FangnanWei/ActiveAmplifier/Document/MO600PAL-V11 硬件测试代码/MO600PAL-V11 硬件测试代码.docx

MO600PAL-V11 硬件测试代码

1、OLED 128 x 64 测试

全亮3秒 全黑3秒 全屏字符 3秒 循环

2、EC11旋转编码器测试

顺时针旋转依次点亮EDPWR EDSYS EDERR三个LED

逆时针旋转依次点亮EDERR EDSYS EDPWR三个LED

3、PWM测试

LVELPWM出50%占空比波形

4、按键蜂鸣器测试

每次按下SYSRST按键，按键按下有效，BEEP输出4kHz方波500毫秒
