FangnanWei/ActiveAmplifier/Reference/老项目代码/Dpa600V2PanelCtrler/stm8.png

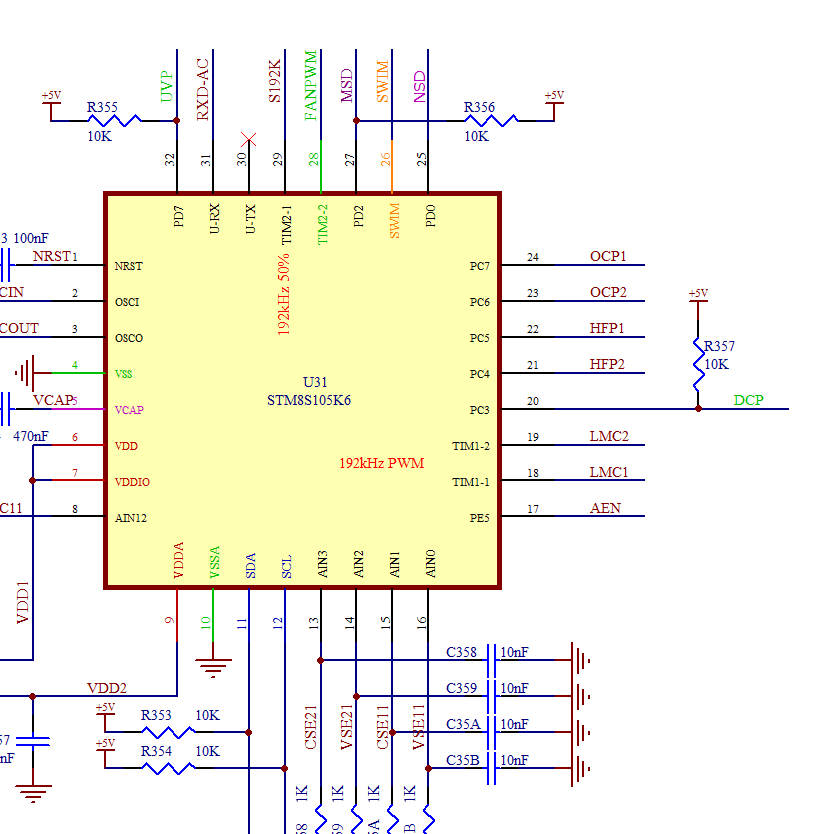
Reference/老项目代码/Dpa600V2PanelCtrler/stm8.png
