FangnanWei/ActiveAmplifier/Document/MO600PAL-V11 硬件测试代码/MO600DSP-V10-P3-5.Sch-200105.pdf

LINKLED | 25 DUPLED | 26 ACTLED | 27 VDD | 28 GND | 29 XI/CLKIN | 30 XO | 31 SCSn | 32 SCLK | 33 MISO | 34 MOSI | 35 INTn | 36

U31

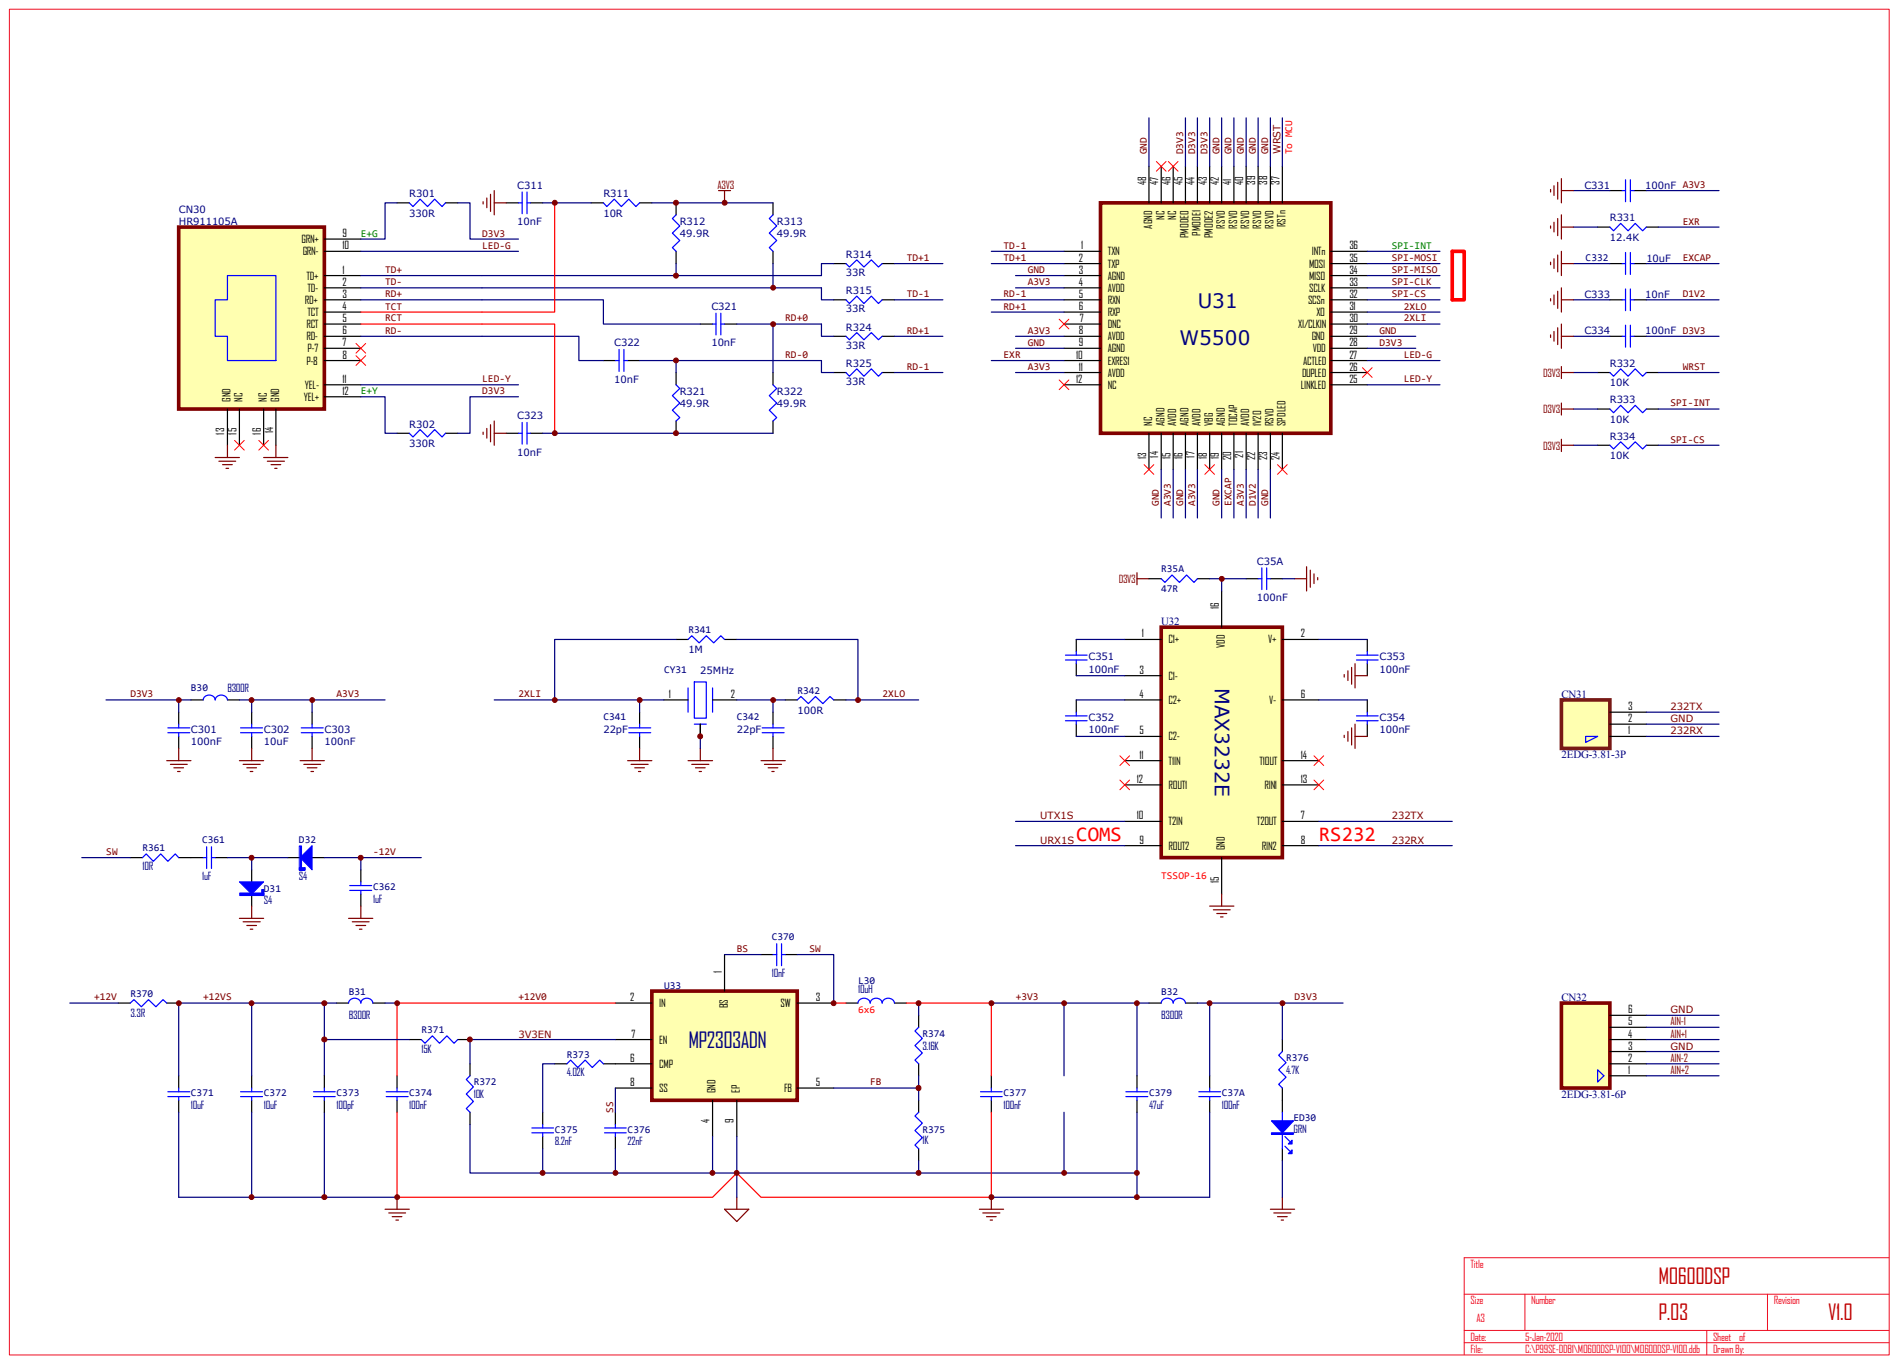
[picture p5: page 1]

RSTn 37 RSVD 38 RSVD 39 RSVD 40 RSVD 41 RSVD 42 PMODE2 43 PMODE1 44 PMODE0 45 NC 46 NC 47 AGND 48

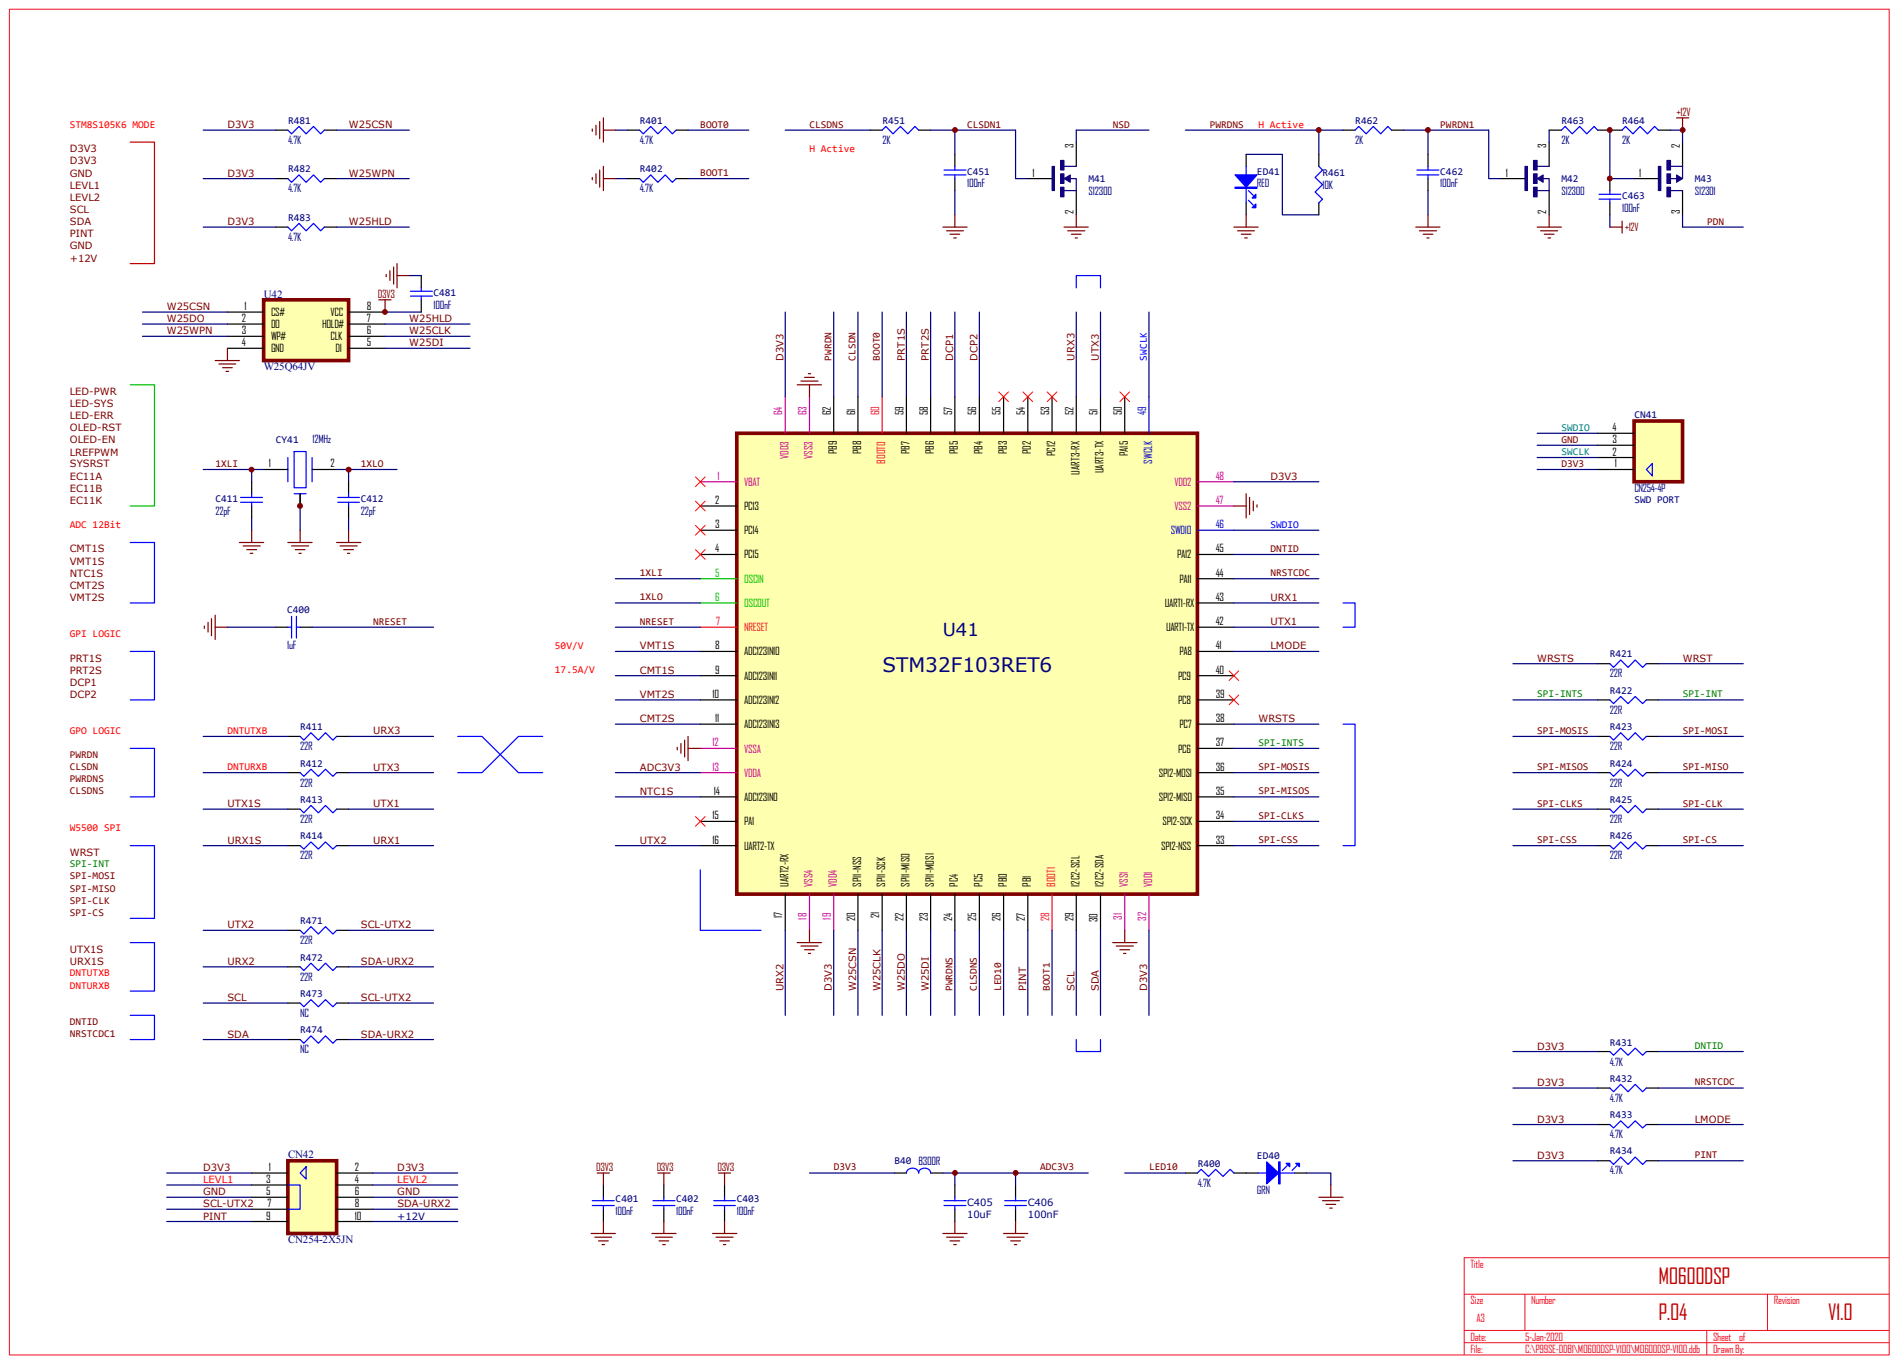
[picture p6: page 2]

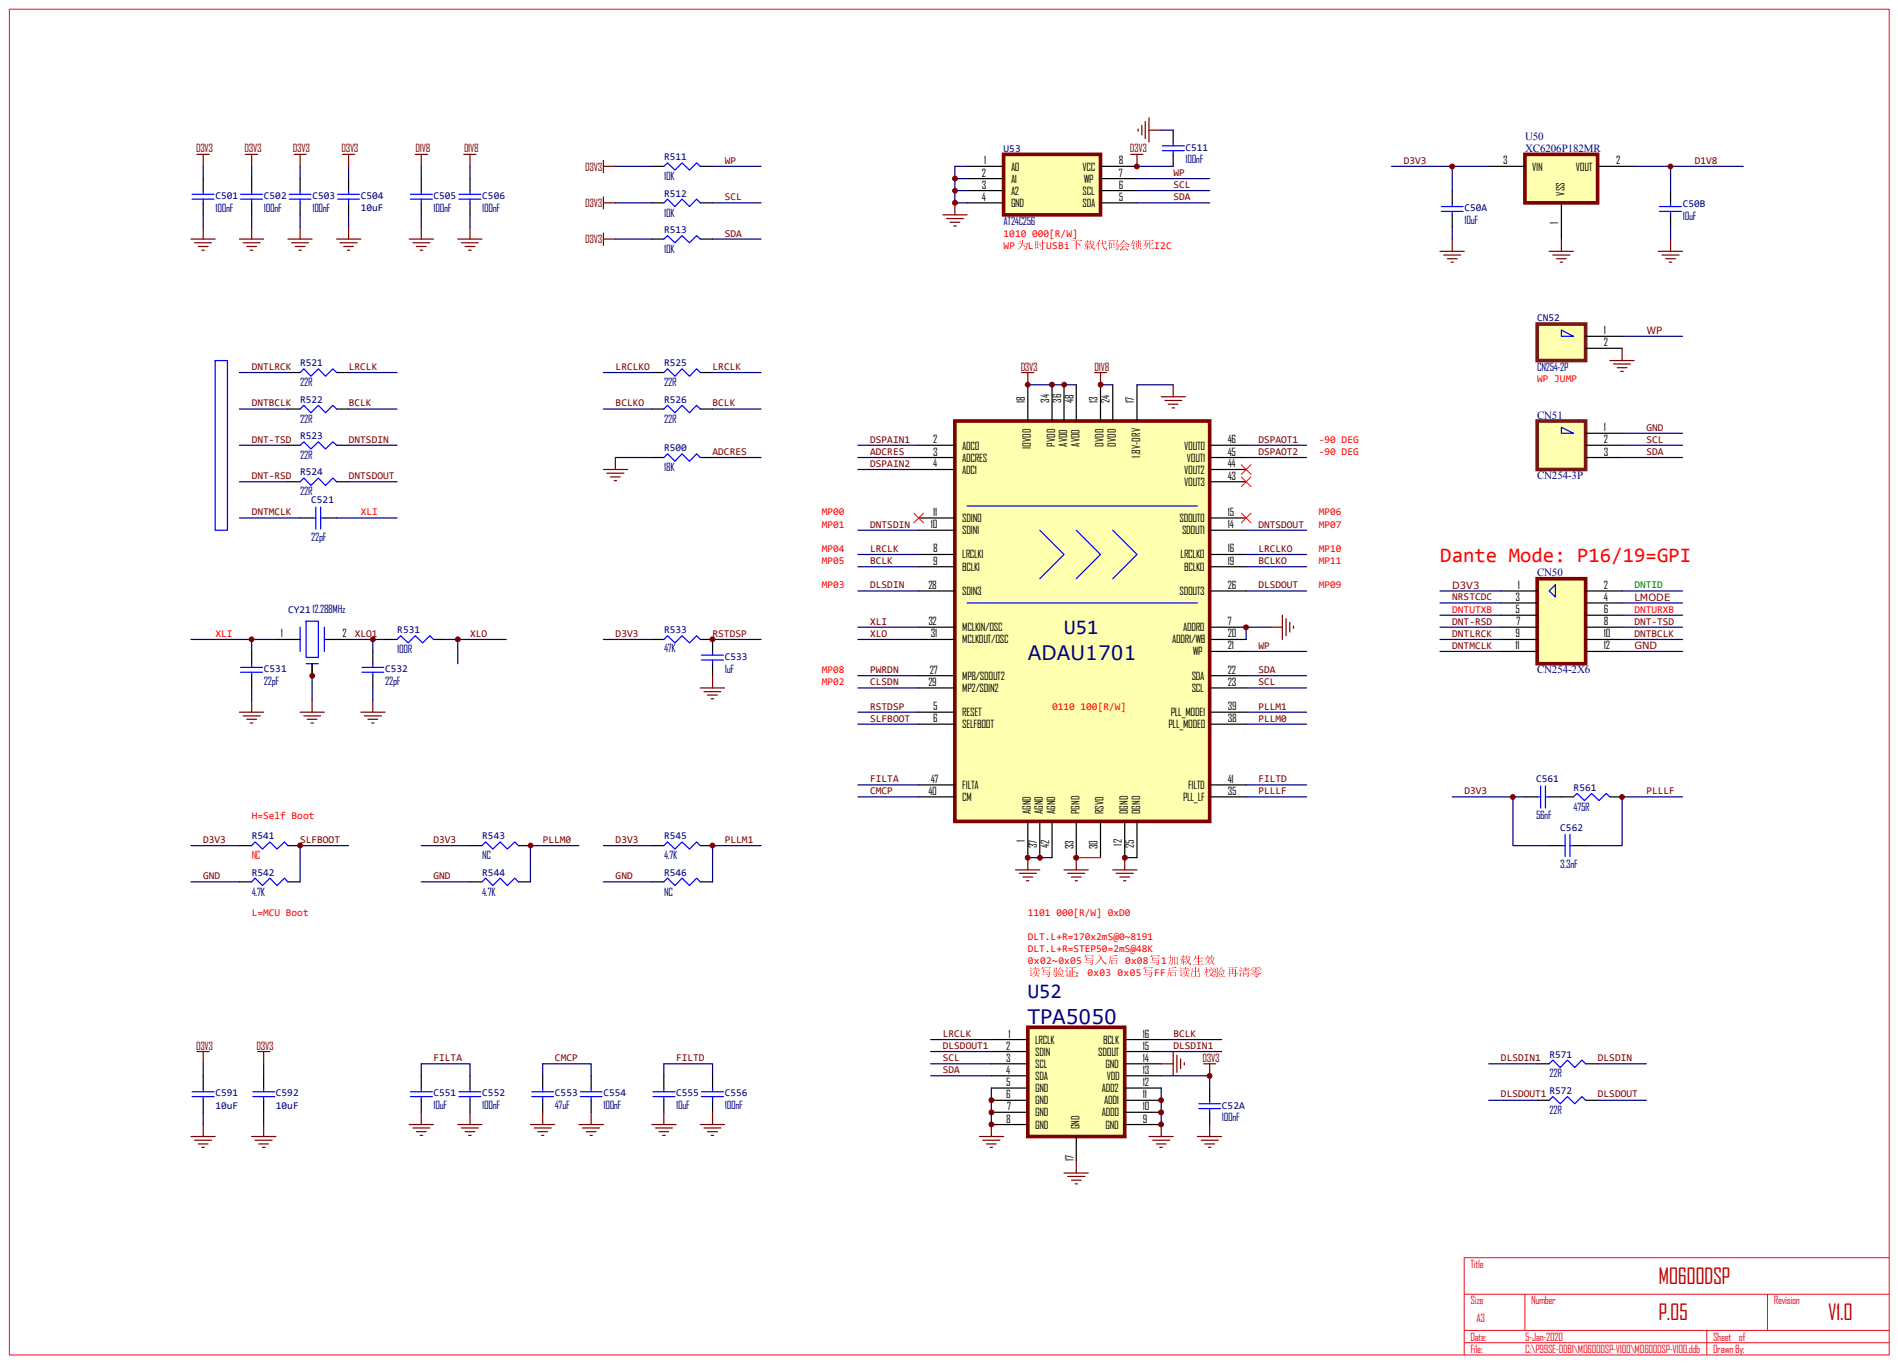
[picture p7: page 3]
