FangnanWei/ActiveAmplifier/Document/ApDoc/DSPDNT-V1.0-40-181101.pdf

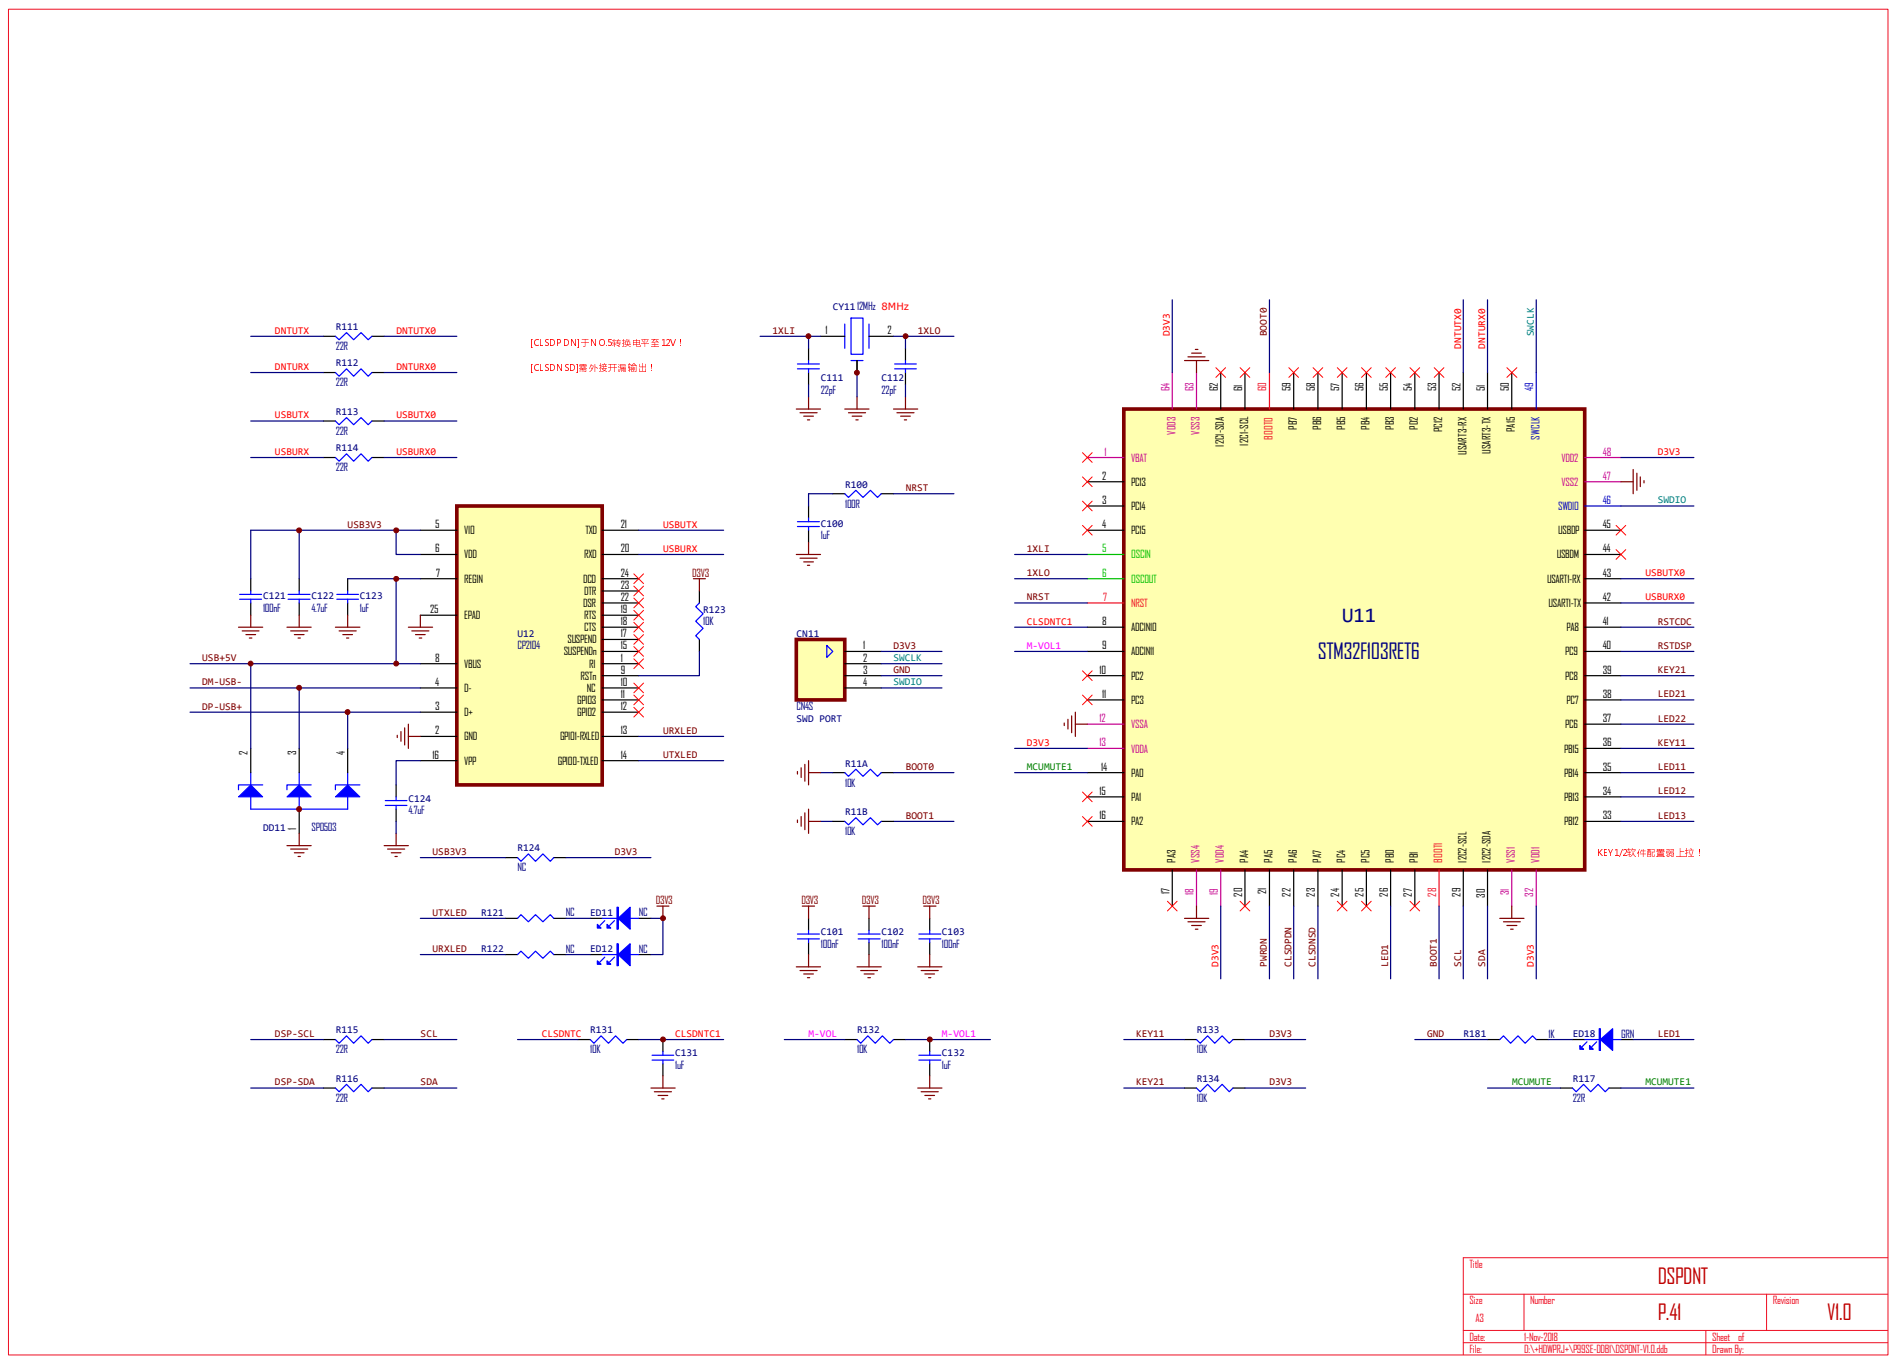
[picture p8: page 1]

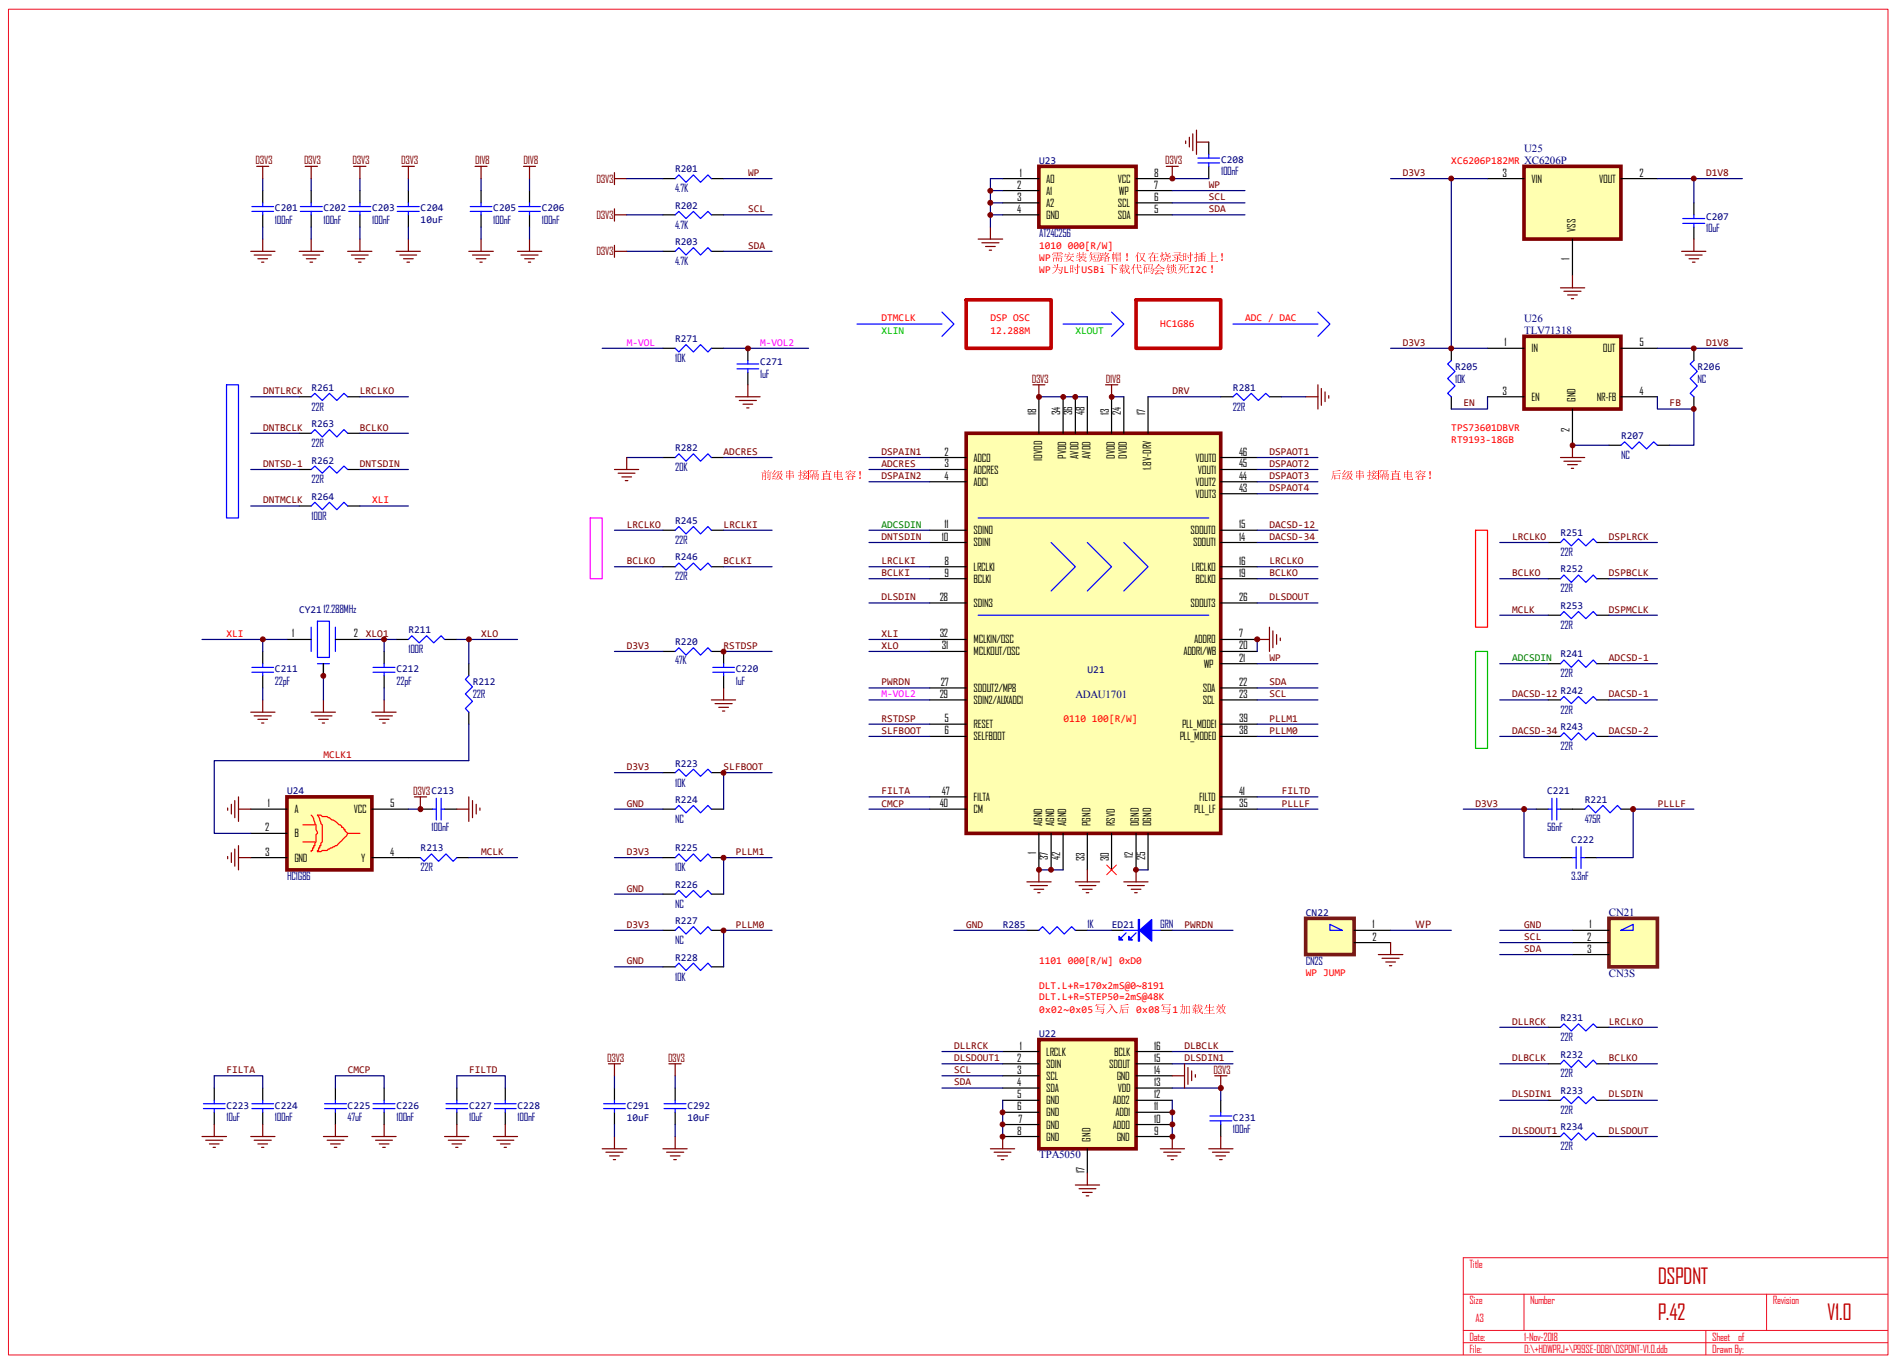
[picture p9: page 2]
