FangnanWei/ActiveAmplifier/Document/MO600PAL-V11 硬件测试代码/DPA600-00V21-FCTRL-1.SCH.pdf

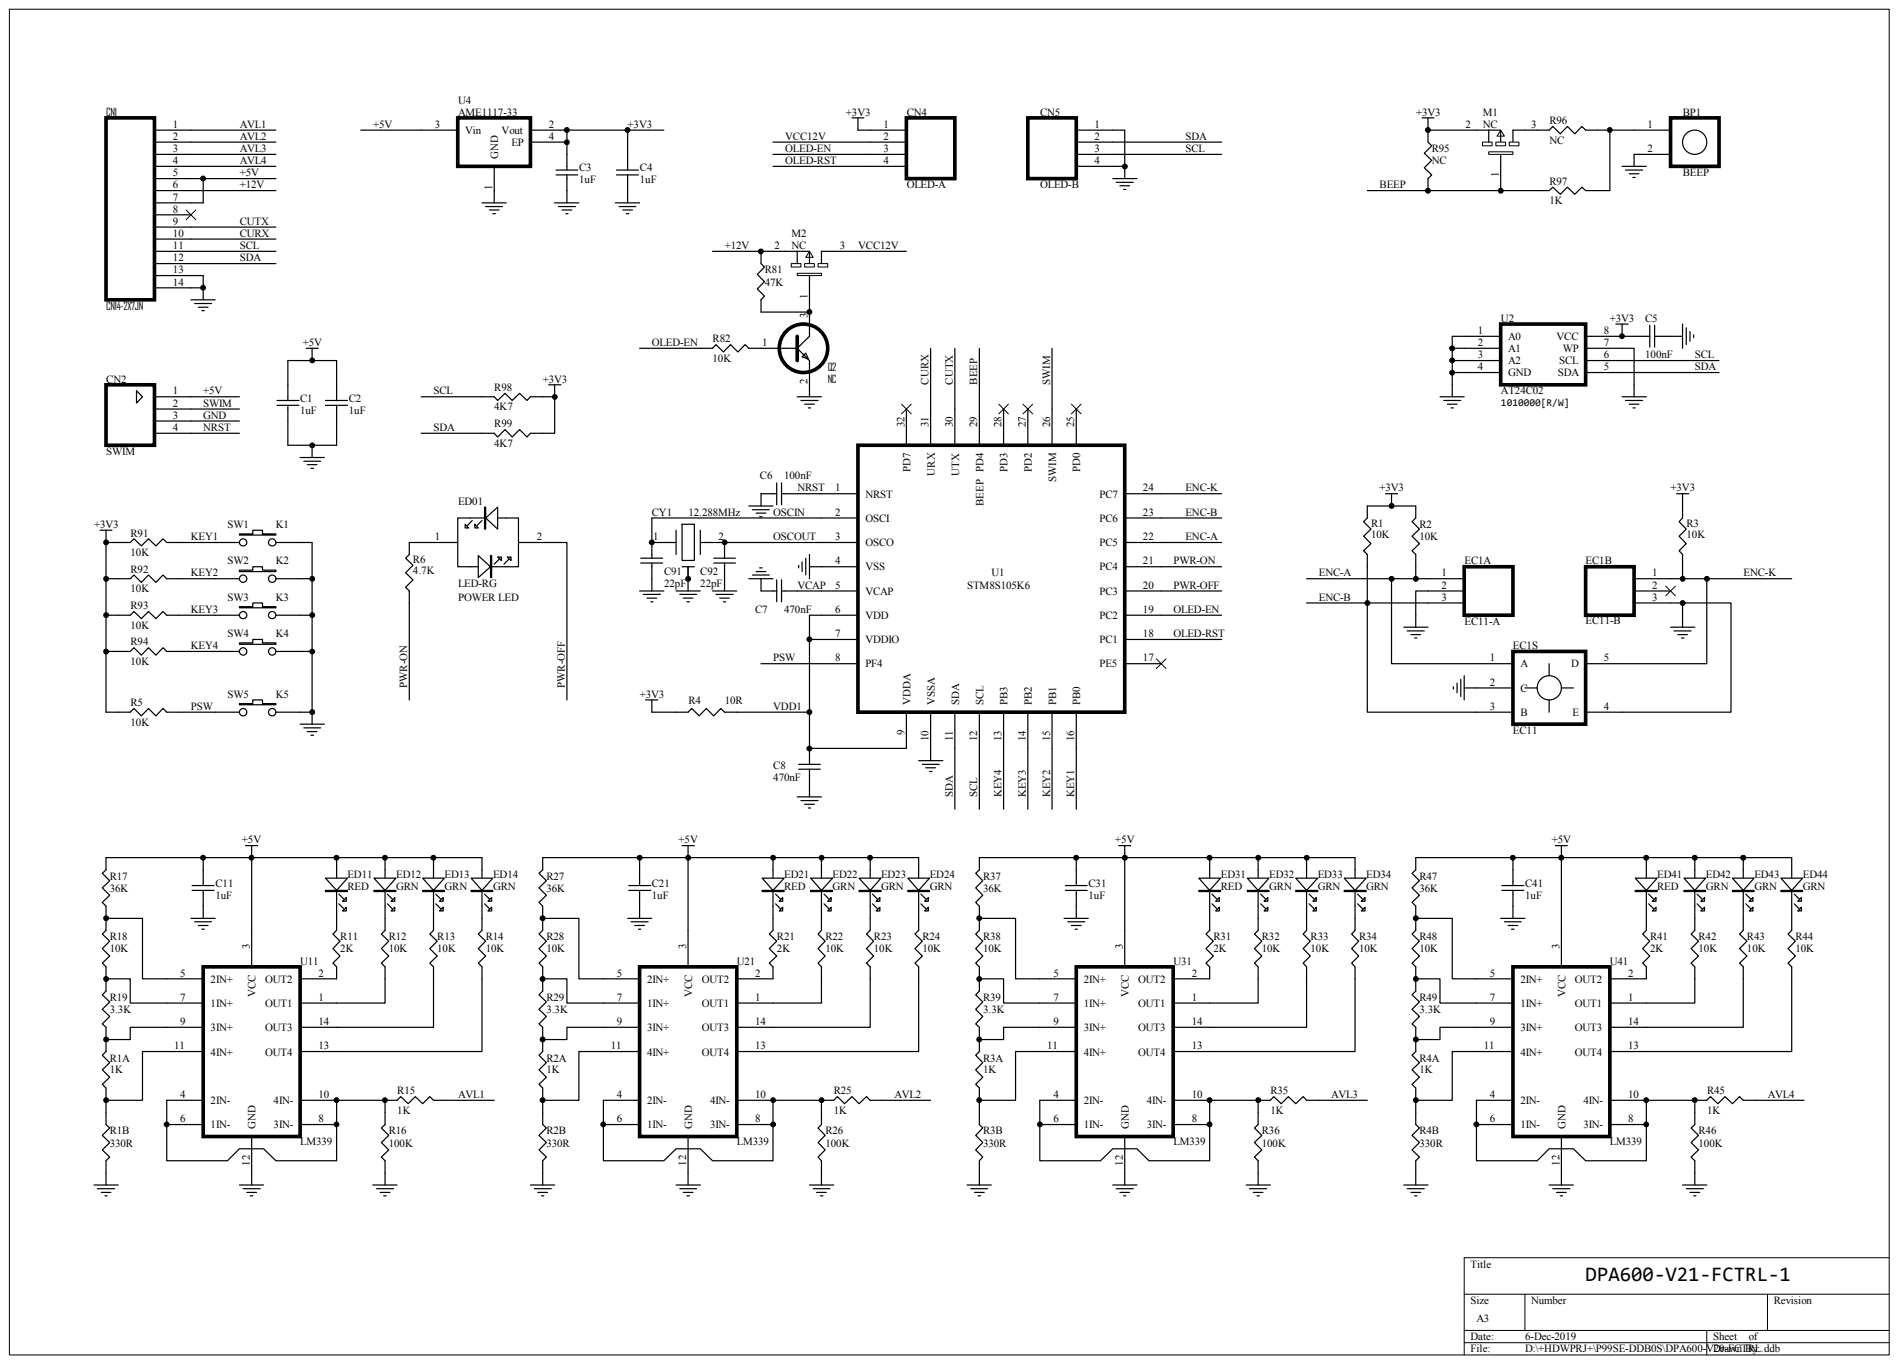
[picture p10: page 1]
