FangnanWei/ActiveAmplifier/Document/MO600PAL-V11 硬件测试代码/MO600PAL-V11-01.sch-001.pdf

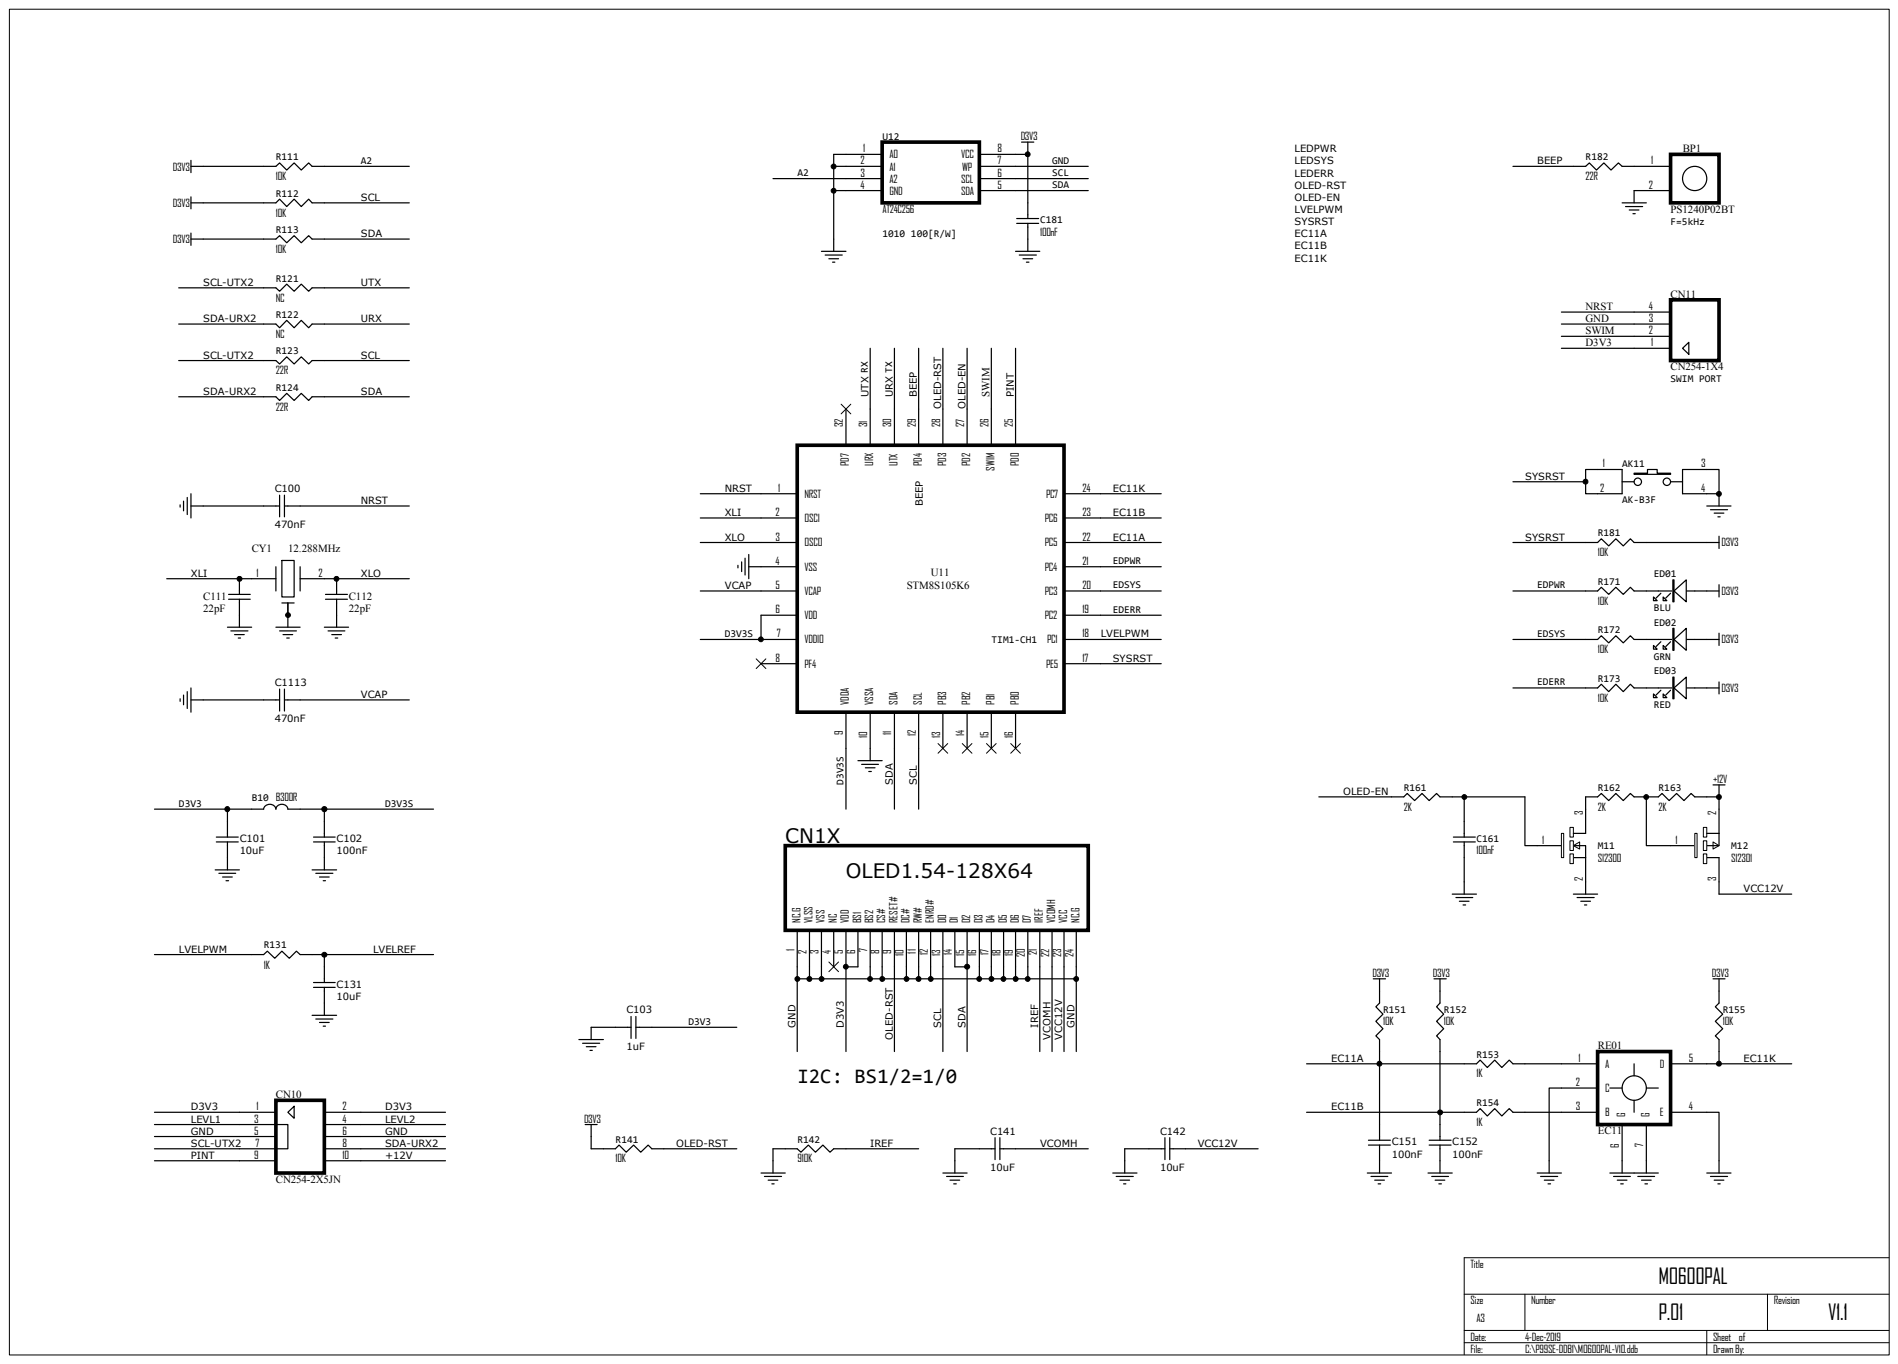
[picture p11: page 1]
