FangnanWei/ActiveAmplifier/Document/MO600PAL-V11 硬件测试代码/2020-01/MO-2300D DSP板MCU程序-1.pdf

## DSP板STM32上电过程

## 7、等待前控板接收并加载完参数表

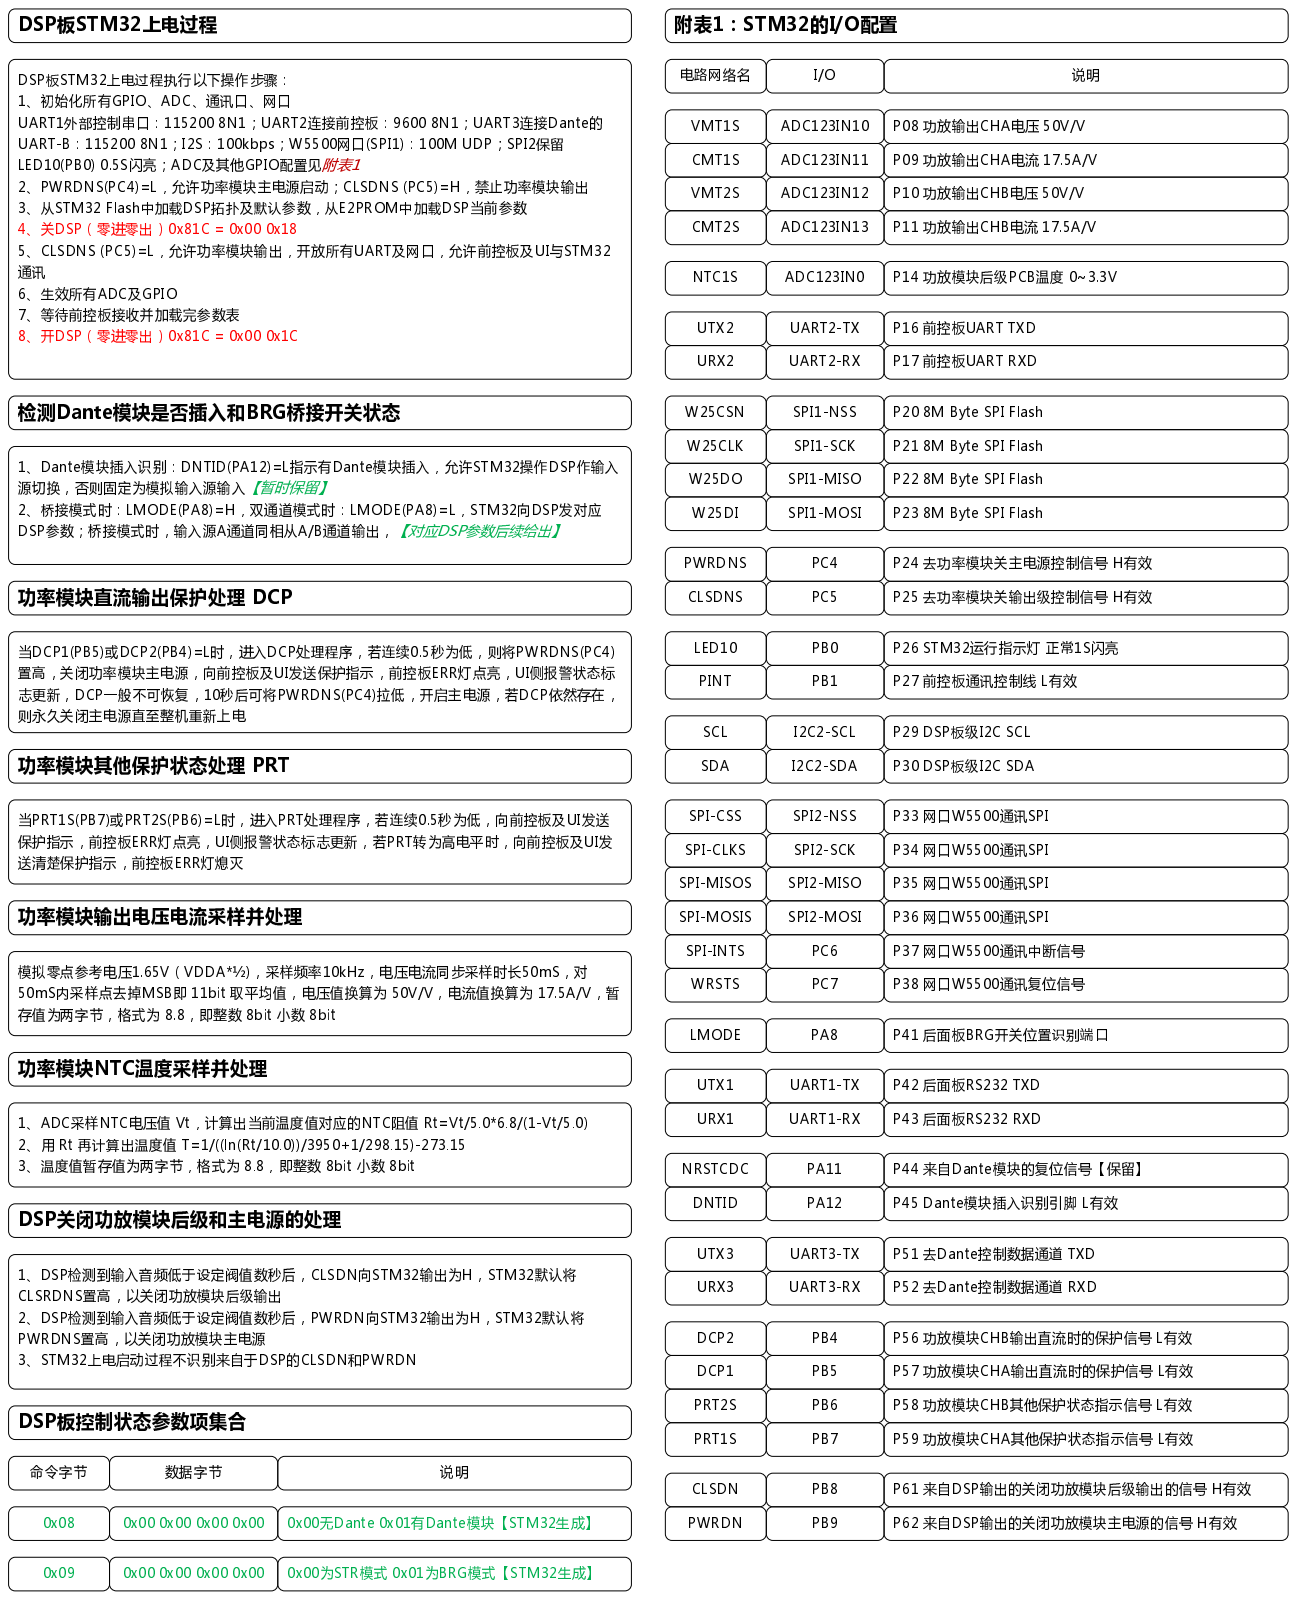
[picture p12: page 1]

1、初始化所有GPIO、ADC、通讯口、网口

2、PWRDNS(PC4)=L，允许功率模块主电源启动；CLSDNS (PC5)=H，禁止功率模块输出

2、桥接模式时：LMODE(PA8)=H，双通道模式时：LMODE(PA8)=L，STM32向DSP发对应
DSP参数；桥接模式时，输入源A通道同相从A/B通道输出，

当DCP1(PB5)或DCP2(PB4)=L时，进入DCP处理程序，若连续0.5秒为低，则将PWRDNS(PC4)
置高，关闭功率模块主电源，向前控板及UI发送保护指示，前控板ERR灯点亮，UI侧报警状态标

志更新，DCP一般不可恢复，10秒后可将PWRDNS(PC4)拉低，开启主电源，若DCP依然存在，
则永久关闭主电源直至整机重新上电

当PRT1S(PB7)或PRT2S(PB6)=L时，进入PRT处理程序，若连续0.5秒为低，向前控板及UI发送
保护指示，前控板ERR灯点亮，UI侧报警状态标志更新，若PRT转为高电平时，向前控板及UI发
送清楚保护指示，前控板ERR灯熄灭

50mS内采样点去掉MSB即 11bit 取平均值，电压值换算为 50V/V，电流值换算为 17.5A/V，暂
存值为两字节，格式为 8.8，即整数 8bit 小数 8bit

1、ADC采样NTC电压值 Vt，计算出当前温度值对应的NTC阻值 Rt=Vt/5.0*6.8/(1-Vt/5.0)

2、用 Rt 再计算出温度值 T=1/((ln(Rt/10.0))/3950+1/298.15)-273.15
3、温度值暂存值为两字节，格式为 8.8，即整数 8bit 小数 8bit

## 需控制的DSP项目说明

DSP模式名称 | 说明
输入源选择 | 0x000h = 0x00 0x00 0x00 0x00 / 0x00 0x00 0x00 0x01【前控板0x12=0x00 / 0x01 = 模拟输入/Dante输入】
CHA/CHB STR模式 | 0x111h = 0x00 0x00 0x00 0x00 / 0x112h = 0x00 0x00 0x00 0x00【后面板BRG开关=L为STR模式】
CHA输入BRG模式 | 0x111h = 0x00 0x00 0x00 0x00 / 0x112h = 0x00 0x00 0x00 0x01【后面板BRG开关=H为BRG模式】
CHA/CHB主衰减 | 0x10Fh/0x110h = 0x00 0x80 0x00 0x00~0x00 0x00 0x03 0x47【前控板0x51/0x52= 0x00~0xB0(0~-80dB)】
CHA/CHB静音 | 0x10Bh/0x10Dh = 0x00 0x80 0x00 0x00/0x00 0x00 0x00 0x00【前控板0x53/0x54= 0x00/0x01(通过/静音)】
CHA/CHB输入增益 | 0x007h/0x008h = 0x00 0xFF 0x64 0xC1/0x00 0x80 0x00 0x00/0x00 0x40 0x26 0xE7【前控板0x13=0x00/0x01/0x02】
4R-70V模式 | 0x105h = 0x00 0x59 0x99 0x9A / 0x106h = 0x00 0x59 0x99 0x9A【前控板0x11=0x00为4R-70V模式】
8R-100V模式 | 0x105h = 0x00 0x80 0x00 0x00 / 0x106h = 0x00 0x80 0x00 0x00【前控板0x11=0x01为8R-100V模式】
