FangnanWei/ActiveAmplifier/Document/MO600PAL-V11 硬件测试代码/2020-01/MO-2300D OLED 界面设计-2.pdf

## 前控板上电过程

## 前控板上电过程执行以下操作：

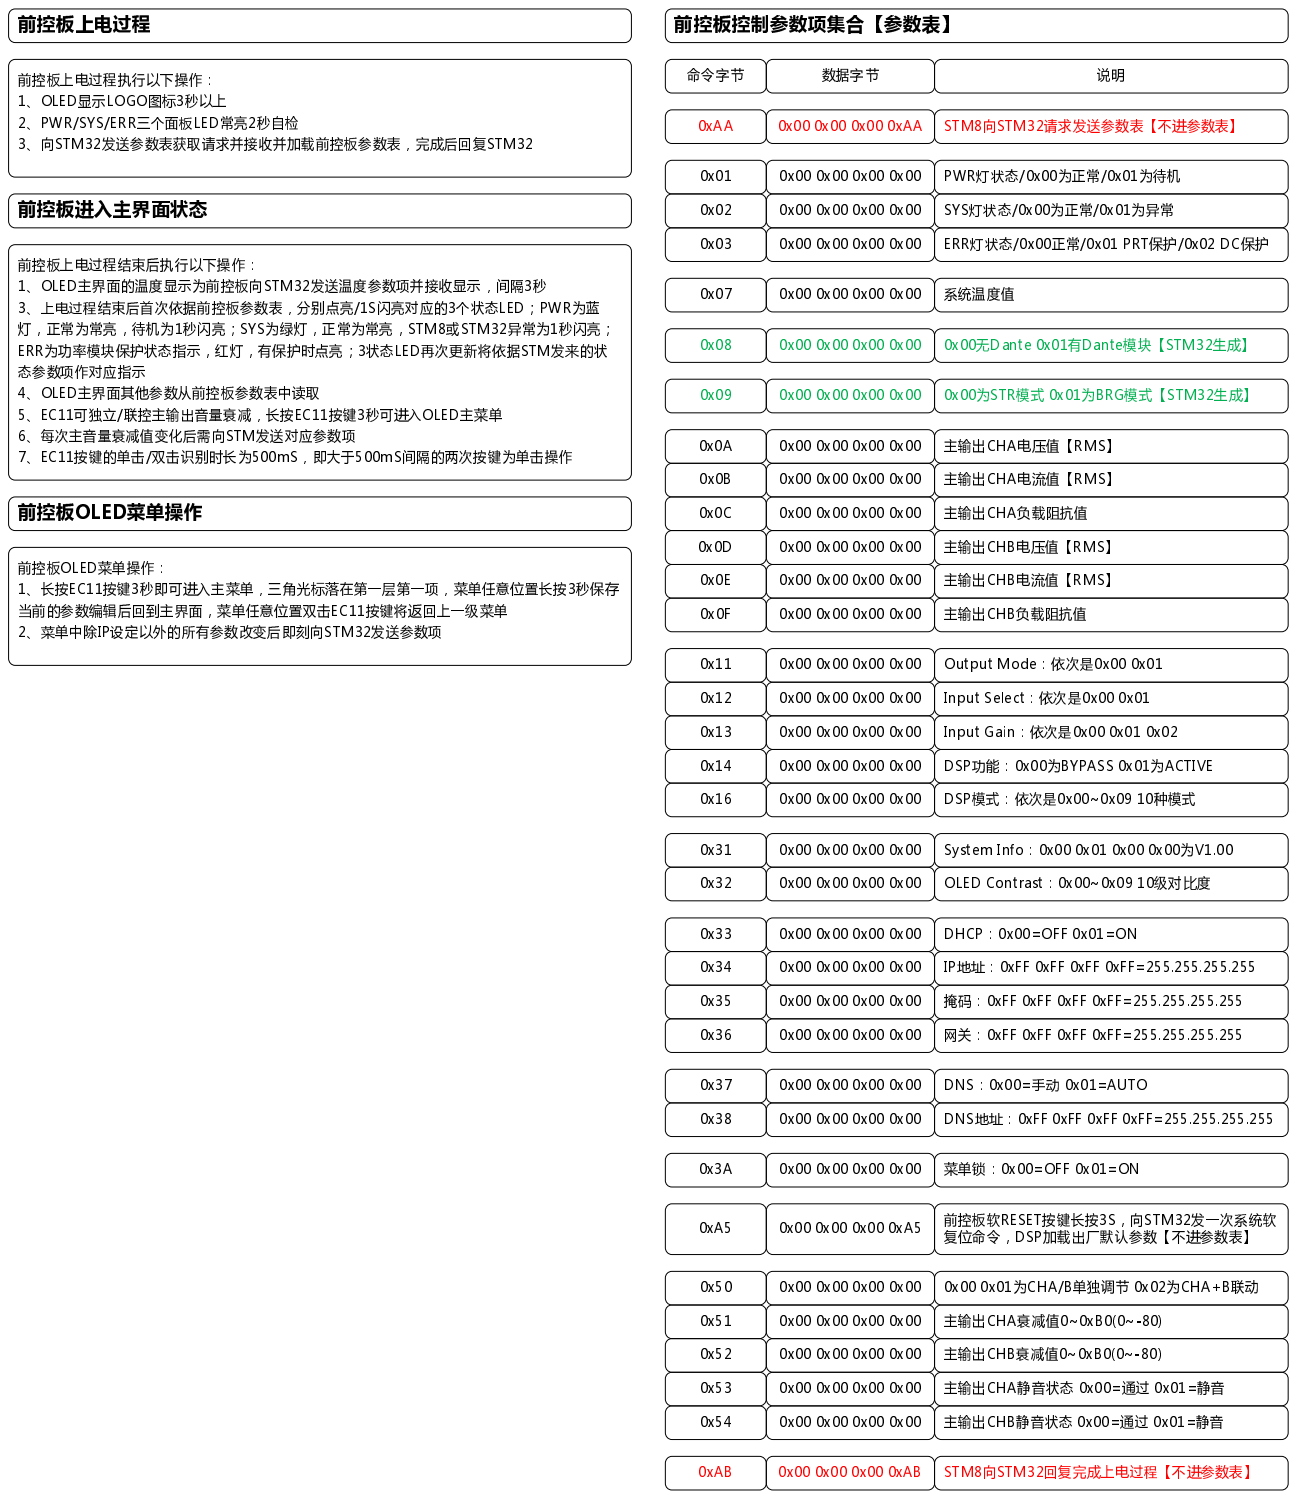
[picture p13: page 1]
1、OLED显示LOGO图标3秒以上; 2、PWR/SYS/ERR三个面板LED常亮2秒自检; 3、向STM32发送参数表获取请求并接收并加载前控板参数表，完成后回复STM32; 前控板进入主界面状态; 5、EC11可独立/联控主输出音量衰减，长按EC11按键3秒可进入OLED主菜单; 6、每次主音量衰减值变化后需向STM发送对应参数项; 7、EC11按键的单击/双击识别时长为500mS，即大于500mS间隔的两次按键为单击操作; 前控板OLED菜单操作; 前控板OLED菜单操作：; 1、长按EC11按键3秒即可进入主菜单，三角光标落在第一层第一项，菜单任意位置长按3秒保存; 当前的参数编辑后回到主界面，菜单任意位置双击EC11按键将返回上一级菜单; 2、菜单中除IP设定以外的所有参数改变后即刻向STM32发送参数项; 主输出CHB电流值【RMS】; 主输出CHB负载阻抗值; Output Mode：依次是0x00 0x01; Input Select：依次是0x00 0x01; Input Gain：依次是0x00 0x01 0x02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

前控板上电过程结束后执行以下操作：
1、OLED主界面的温度显示为前控板向STM32发送温度参数项并接收显示，间隔3秒
3、上电过程结束后首次依据前控板参数表，分别点亮/1S闪亮对应的3个状态LED；PWR为蓝
灯，正常为常亮，待机为1秒闪亮；SYS为绿灯，正常为常亮，STM8或STM32异常为1秒闪亮；
ERR为功率模块保护状态指示，红灯，有保护时点亮；3状态LED再次更新将依据STM发来的状
态参数项作对应指示
4、OLED主界面其他参数从前控板参数表中读取

复位命令，DSP加载出厂默认参数【不进参数表】

## 开机画面

# G a i n : + 6 d B T m p : 3 2 º C C H A ▌ ▌ ▌ ▌ ▌ ▌ ▌ ▌ ▌ ▌ C H B ▌ ▌ ▌ ▌ ▌ ▌ ▌ ▌ ▌ ▌

I P : 1 9 2 . 1 6 8 . 0 0 0 . 0 0 1

# G a i n : + 6 d B T m p : 3 2 º C C H A - - - M U T E D - - -C H B - - - M U T E D - - -

I P : 1 9 2 . 1 6 8 . 0 0 0 . 0 0 1

## 主界面

### 说明：主界面的CHA/CHB的输出衰减 范围为0~-80dB，三角光标指示可调整

## 状态；EC11旋转改变衰减值，双击按键 可静音

# 菜单界面 1

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

# O u t p u t M o d e ◄

# I n p u t G a i n

# I n p u t S e l e c t

# D S P

# S T R - 4 R / B R G 7 0 V S T R - 8 R / B R G 1 0 0 V ●

# O u t p u t M o d e

# I n p u t G a i n

# I n p u t S e l e c t ◄

# D S P

# A n a l o g ◄ D a n t e ●

# O u t p u t M o d e

# I n p u t G a i n ◄

# I n p u t S e l e c t

# D S P

+ 6 d B
+ 0 d B ● ◄
- 6 d B

# O u t p u t M o d e

# I n p u t G a i n

# I n p u t S e l e c t

# D S P ◄

# B y p a s s A c t i v e ● ◄ M o d e : < 9 >

# 菜单界面 2

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

# C H A : 5 0 V r m s C H B : 5 0 V r m s T e m p : 3 2 º C

# 菜单界面 3

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

# V e r s i o n : 1 . 0 0

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

# C o n t r a s t : < 1 0 >

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

# D H C P < O N >

I P ◄

# D N S

I P : 1 9 2 . 1 6 8 . 0 0 0 . 0 1 0 M K : 2 5 5 . 2 5 5 . 2 5 5 . 0 0 0 G W : 1 9 2 . 1 6 8 . 0 0 0 . 0 0 1

# D H C P < O N >

I P

# D N S ◄

# A u t o < O N >

D N : 1 9 2 . 1 6 8 . 0 0 0 . 0 0 1

## 说明：三角光标指示当前菜单条，圆点

### 指示当前生效选项

### 说明：Display为无EC11操作的信息显

示，STM8间隔1S向STM32发信息获取

### 请求，接收到正确的信息后刷新显示，

## 每一个显示条为一个条通信参数（4字 节），STM8每次接收3条参数

### 说明：进入IP地址（含DNS）编辑界面

## 中后，单击EC11按键进入或退出编辑状

### 态，数字字符在编辑状态时反白显示，

EC11旋转改变数值，DHCP打开时从
STM32获取IP地址值而不可编辑，DNS
为AUTO时也从STM32获取而不可编辑
