FangnanWei/ActiveAmplifier/Code/FrontPanel/src/App/McuMsg.cpp

/*************************************************
				McuMsg.h
*************************************************/
#include "App/McuMsg.h"

#include "stdlib.h"
#include "stdio.h"

#if 0
#include "common_def.h"
#include "dsp.h"
#include "uart.h"
#include "comfifo.h"
#include "eeprom.h"
#include "Scene.h"
#include "Adc.h"
#include "iap.h"
#include "I2C.h"
#include "led.h"
#include "flash_if.h"
#include "key.h"
#include "packet.h"
#include "reset.h"
#include "tpa5050.h"
#include "uart.h"
#include "Time.h"
#endif

#include <stdlib.h>
#include <string.h>

/*************************************************
				include
*************************************************/

/*************************************************
				macro
*************************************************/

/*************************************************
				typedef
*************************************************/

/*************************************************
				variables
*************************************************/
static const uint32_t crc32tab[] =
{
    0x00000000L, 0x77073096L, 0xee0e612cL, 0x990951baL,
    0x076dc419L, 0x706af48fL, 0xe963a535L, 0x9e6495a3L,
    0x0edb8832L, 0x79dcb8a4L, 0xe0d5e91eL, 0x97d2d988L,
    0x09b64c2bL, 0x7eb17cbdL, 0xe7b82d07L, 0x90bf1d91L,
    0x1db71064L, 0x6ab020f2L, 0xf3b97148L, 0x84be41deL,
    0x1adad47dL, 0x6ddde4ebL, 0xf4d4b551L, 0x83d385c7L,
    0x136c9856L, 0x646ba8c0L, 0xfd62f97aL, 0x8a65c9ecL,
    0x14015c4fL, 0x63066cd9L, 0xfa0f3d63L, 0x8d080df5L,
    0x3b6e20c8L, 0x4c69105eL, 0xd56041e4L, 0xa2677172L,
    0x3c03e4d1L, 0x4b04d447L, 0xd20d85fdL, 0xa50ab56bL,
    0x35b5a8faL, 0x42b2986cL, 0xdbbbc9d6L, 0xacbcf940L,
    0x32d86ce3L, 0x45df5c75L, 0xdcd60dcfL, 0xabd13d59L,
    0x26d930acL, 0x51de003aL, 0xc8d75180L, 0xbfd06116L,
    0x21b4f4b5L, 0x56b3c423L, 0xcfba9599L, 0xb8bda50fL,
    0x2802b89eL, 0x5f058808L, 0xc60cd9b2L, 0xb10be924L,
    0x2f6f7c87L, 0x58684c11L, 0xc1611dabL, 0xb6662d3dL,
    0x76dc4190L, 0x01db7106L, 0x98d220bcL, 0xefd5102aL,
    0x71b18589L, 0x06b6b51fL, 0x9fbfe4a5L, 0xe8b8d433L,
    0x7807c9a2L, 0x0f00f934L, 0x9609a88eL, 0xe10e9818L,
    0x7f6a0dbbL, 0x086d3d2dL, 0x91646c97L, 0xe6635c01L,
    0x6b6b51f4L, 0x1c6c6162L, 0x856530d8L, 0xf262004eL,
    0x6c0695edL, 0x1b01a57bL, 0x8208f4c1L, 0xf50fc457L,
    0x65b0d9c6L, 0x12b7e950L, 0x8bbeb8eaL, 0xfcb9887cL,
    0x62dd1ddfL, 0x15da2d49L, 0x8cd37cf3L, 0xfbd44c65L,
    0x4db26158L, 0x3ab551ceL, 0xa3bc0074L, 0xd4bb30e2L,
    0x4adfa541L, 0x3dd895d7L, 0xa4d1c46dL, 0xd3d6f4fbL,
    0x4369e96aL, 0x346ed9fcL, 0xad678846L, 0xda60b8d0L,
    0x44042d73L, 0x33031de5L, 0xaa0a4c5fL, 0xdd0d7cc9L,
    0x5005713cL, 0x270241aaL, 0xbe0b1010L, 0xc90c2086L,
    0x5768b525L, 0x206f85b3L, 0xb966d409L, 0xce61e49fL,
    0x5edef90eL, 0x29d9c998L, 0xb0d09822L, 0xc7d7a8b4L,
    0x59b33d17L, 0x2eb40d81L, 0xb7bd5c3bL, 0xc0ba6cadL,
    0xedb88320L, 0x9abfb3b6L, 0x03b6e20cL, 0x74b1d29aL,
    0xead54739L, 0x9dd277afL, 0x04db2615L, 0x73dc1683L,
    0xe3630b12L, 0x94643b84L, 0x0d6d6a3eL, 0x7a6a5aa8L,
    0xe40ecf0bL, 0x9309ff9dL, 0x0a00ae27L, 0x7d079eb1L,
    0xf00f9344L, 0x8708a3d2L, 0x1e01f268L, 0x6906c2feL,
    0xf762575dL, 0x806567cbL, 0x196c3671L, 0x6e6b06e7L,
    0xfed41b76L, 0x89d32be0L, 0x10da7a5aL, 0x67dd4accL,
    0xf9b9df6fL, 0x8ebeeff9L, 0x17b7be43L, 0x60b08ed5L,
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
};
/*************************************************
				function
*************************************************/
uint32_t Calcrc32(const uint8_t *buf, uint32_t size)
{
    uint32_t i;
    uint32_t crc;

    crc = 0xFFFFFFFF;
    for (i = 0; i < size; i++)
    {
        crc = crc32tab[(crc ^ buf[i]) & 0xff] ^ (crc >> 8);
    }
    return crc^0xFFFFFFFF;
}

uint32_t CalcMsgCrc(McuMsg_t *pMsg)
{
	pMsg->header.crc = 0;
	pMsg->header.crc = Calcrc32((const uint8_t*)pMsg, pMsg->header.len + sizeof(McuMsgHeader_t));
	return pMsg->header.crc;
}

Bool CheckMsgCrc(McuMsg_t *pMsg)
{
	uint32_t crcsave = pMsg->header.crc;

	CalcMsgCrc(pMsg);
	return (crcsave == pMsg->header.crc);
}

/* 查找消息头 */
static Bool findMcuMsgHeader(ComFifo_t *pComFifo)
{
	while(1)
	{
		uint16_t magic = 0;

		if (GetFifoDataLen(pComFifo) < sizeof(magic)){
			return False;
		}

		CopyReadComFifo(pComFifo, (char*)&magic, sizeof(magic));
		if (magic == MCU_MSG_MAGIC)
		{
			return True;
		}
		else
		{
			ReadComFifo(pComFifo, (char*)&magic, 1);
		}
	}
}

Bool GetMcuMsg(ComFifo_t *pComFifo, McuMsg_t *pMsg)
{
	uint16_t len;
	uint16_t packLen;
	if (False == findMcuMsgHeader(pComFifo)) {
		return False;
	}

	len = GetFifoDataLen(pComFifo);
	if (len < sizeof(McuMsgHeader_t)) {
		return False;
	}
	CopyReadComFifo(pComFifo, (char *)pMsg, sizeof(McuMsgHeader_t));
	len = GetFifoDataLen(pComFifo);
	packLen = pMsg->header.len + sizeof(McuMsgHeader_t);
	if (packLen > len) {
		return False;	/* 消息不完整 */
	}

	ReadComFifo(pComFifo, (char*)pMsg, packLen);
	return CheckMsgCrc(pMsg);
}

void MakeMcuMsg(McuMsg_t *pMsg, uint8_t *buf, uint16_t len, DI_RET_e code, McuMsgType_e msgType, uint16_t reqId)
{
	if (buf && len){
		memcpy(pMsg->content.data, buf, len);
	}
	pMsg->header.magic = MCU_MSG_MAGIC;
	pMsg->header.errCode = code;
	pMsg->header.len = len;
	pMsg->header.msgType = msgType;

	pMsg->header.reqId = reqId;
	CalcMsgCrc(pMsg);
}

////写出所有的消息处理函数
extern const char *_SoftVersion;

int32_t AP_MsgRebootMcu(AP_Inst_t *inst, McuMsg_t *msg)
{
	uint32_t IAPFlag = IAP_FAIL;
	
	SendPacket(NULL, 0, DI_Ok, MSG_MCU_Reboot, msg->header.reqId);
	FLASH_If_Init();
	FLASH_CFG_Erase((uint32_t)UPDATE_FLASH_FLAG_ADDRESS);
	FLASH_CFG_Write((int32_t)UPDATE_FLASH_FLAG_ADDRESS, &IAPFlag, sizeof(uint32_t));
	FLASH_if_UnInit();
	I2C_DeInit(I2C1);
	USART_DeInit(USART1);
	USART_DeInit(USART2);
	CLI();//关闭总中断
	Jmp2Boot();
	
	return 0;
}

int32_t AP_MsgDspTopoUpdateMode(AP_Inst_t *inst, McuMsg_t *msg)
{
	uint32_t DSPIAPFlag = IAP_FAIL;
	
	SendPacket(NULL, 0, DI_Ok, MSG_DSP_TOPO_UpdateMode, msg->header.reqId);
	FLASH_If_Init();
	FLASH_CFG_Erase((uint32_t)UPDATE_DSP_TOPO_FLASH_FLAG_ADDRESS);
	FLASH_CFG_Write((int32_t)UPDATE_DSP_TOPO_FLASH_FLAG_ADDRESS, &DSPIAPFlag, sizeof(uint32_t));
	FLASH_if_UnInit();
	
	while(1)
	{
		EraseDSP_Topo();
		DSP_TopoUpgrade(&g_ComFifo);
	}
	return 0;
}

int32_t AP_MsgGetVersion(AP_Inst_t *inst, McuMsg_t *msg)
{
	SendPacket((uint8_t*)_SoftVersion, strlen(_SoftVersion) + 1, DI_Ok, MSG_VERSION_Get, msg->header.reqId);
	return 0;
}

int32_t AP_MsgReadEeprom(AP_Inst_t *inst, McuMsg_t *msg)
{
	MsgE2prom_t *pMsgE2prom = (MsgE2prom_t*)(msg->content.data);
	Read24C256(EEPROM_SLAVE_Addr, 
				pMsgE2prom->address, 
				&msg->content.data[sizeof(MsgE2prom_t)], 
				pMsgE2prom->len);
	SendPacket((uint8_t*)pMsgE2prom, sizeof(MsgE2prom_t)+pMsgE2prom->len, DI_Ok, MSG_EEPROM_Read, msg->header.reqId);

	return 0;
}

int32_t AP_MsgWriteEeprom(AP_Inst_t *inst, McuMsg_t *msg)
{
	MsgE2prom_t *pMsgE2prom = (MsgE2prom_t*)(msg->content.data);
	Write24C256(EEPROM_SLAVE_Addr, 
				pMsgE2prom->address, 
				&msg->content.data[sizeof(MsgE2prom_t)], 
				pMsgE2prom->len);
	SendPacket((uint8_t*)pMsgE2prom, sizeof(MsgE2prom_t), DI_Ok, MSG_EEPROM_Write, msg->header.reqId);
	return 0;
}

int32_t AP_MsgReadDsp(AP_Inst_t *inst, McuMsg_t *msg)
{
	MsgDsp_t *pMsgDsp = (MsgDsp_t*)(msg->content.data);
	ReadDSP(pMsgDsp->address, 
			&msg->content.data[sizeof(MsgDsp_t)], 
			pMsgDsp->len);
	SendPacket((uint8_t*)pMsgDsp, sizeof(MsgDsp_t)+pMsgDsp->len, DI_Ok, MSG_DSP_Read, msg->header.reqId);
	return 0;
}

int32_t AP_MsgWriteDsp(AP_Inst_t *inst, McuMsg_t *msg)
{
	MsgDsp_t *pMsgDsp = (MsgDsp_t*)(msg->content.data);
	SIGMA_WRITE_REGISTER_BLOCK(DSP_SLAVE_Addr, 
							pMsgDsp->address,
							pMsgDsp->len,
							&msg->content.data[sizeof(MsgDsp_t)]);
	SendPacket((uint8_t*)pMsgDsp, sizeof(MsgDsp_t), DI_Ok, MSG_DSP_Write, msg->header.reqId);
	return 0;
}

int32_t AP_MsgSafeloadDsp(AP_Inst_t *inst, McuMsg_t *msg)
{
	MsgDsp_t *pMsgDsp = (MsgDsp_t*)(msg->content.data);
	SIGMA_SAFELOAD_WRITE_REGISTER(DSP_SLAVE_Addr, 
							pMsgDsp->address,
							pMsgDsp->len,
							&msg->content.data[sizeof(MsgDsp_t)]);
	SendPacket((uint8_t*)pMsgDsp, sizeof(MsgDsp_t), DI_Ok, MSG_DSP_Safeload, msg->header.reqId);
	return 0;
}

int32_t AP_MsgTopoHeaderDsp(AP_Inst_t *inst, McuMsg_t *msg)
{
	DSP_TopoHeader_t *pHeader = GetDSPTopoHeader();
	SendPacket((uint8_t*)pHeader, sizeof(DSP_TopoHeader_t), DI_Ok, MSG_DSP_TopoHeader, msg->header.reqId);
	return 0;
}

int32_t AP_MsgWriteWithExtDsp(AP_Inst_t *inst, McuMsg_t *msg)
{
	struct Scene *scene = inst->scene;
	MsgDspExt_t *pMsgDspExt = (MsgDspExt_t*)(msg->content.data);
#if 0
	SIGMA_WRITE_REGISTER_BLOCK(DSP_SLAVE_Addr, 
							pMsgDspExt->address,
							pMsgDspExt->len,
							&msg_rx.content.data[sizeof(pMsgDspExt)]);
#endif
	//LoadMsgDspExt(pMsgDspExt, True);
	scene->LoadMsgDspExt(scene, pMsgDspExt, True);

	SendPacket((uint8_t*)pMsgDspExt, sizeof(MsgDspExt_t), DI_Ok, MSG_DSP_WriteWithExt, msg->header.reqId);
	return 0;
}

int32_t AP_MsgSafeloadWithExtDsp(AP_Inst_t *inst, McuMsg_t *msg)
{
	struct Scene *scene = inst->scene;
	MsgDspExt_t *pMsgDspExt = (MsgDspExt_t*)(msg->content.data);
	//LoadMsgDspExt(pMsgDspExt, True);
	scene->LoadMsgDspExt(scene, pMsgDspExt, True);
#if 0
	SIGMA_SAFELOAD_WRITE_REGISTER(DSP_SLAVE_Addr, 
							pMsgDspExt->address,
							pMsgDspExt->len,
							&msg_rx.content.data[sizeof(pMsgDspExt)]);
#endif
	SendPacket((uint8_t*)pMsgDspExt, sizeof(MsgDspExt_t), DI_Ok, MSG_DSP_SafeloadWithExt, msg->header.reqId);
	return 0;
}

int32_t AP_MsgSceneChangeDsp(AP_Inst_t *inst, McuMsg_t *msg)
{
	struct Scene *scene = inst->scene;
	uint8_t mode = msg->content.data[0];
	//LoadScene(mode);
	scene->Load(scene, (tagDSP_Scene_e)mode);
	SendPacket(&mode, 1, DI_Ok, MSG_DSP_SCENE_Change, msg->header.reqId);
	return 0;
}

struct AP_Instance *AP_Init(void)
{
	AP_Inst_t *inst = (AP_Inst_t *)malloc(sizeof(AP_Inst_t));
	memset(inst, 0, sizeof(AP_Inst_t));

	//驱动
	inst->drivers.base.i2c = I2c_Open(I2C2);
	inst->drivers.tpa = Tpa5050_Open(inst->drivers.base.i2c);
	inst->drivers.eeprom = Eeprom_Open(inst->drivers.base.i2c);
	inst->drivers.dsp = Dsp_Open(inst->drivers.base.i2c);
	inst->drivers.adc = Adc_Open();

	//消息处理函数
	inst->msg[MSG_MCU_Reboot] = AP_MsgRebootMcu;
	inst->msg[MSG_DSP_TOPO_UpdateMode] = AP_MsgDspTopoUpdateMode;
	inst->msg[MSG_VERSION_Get] = AP_MsgGetVersion;

	inst->msg[MSG_EEPROM_Read] = AP_MsgReadEeprom;
	inst->msg[MSG_EEPROM_Write] = AP_MsgWriteEeprom;
	inst->msg[MSG_DSP_Read] = AP_MsgReadDsp;
	inst->msg[MSG_DSP_Write] = AP_MsgWriteDsp;
	inst->msg[MSG_DSP_Safeload] = AP_MsgSafeloadDsp;
	inst->msg[MSG_DSP_TopoHeader] = AP_MsgTopoHeaderDsp;
	inst->msg[MSG_DSP_WriteWithExt] = AP_MsgWriteWithExtDsp;
	inst->msg[MSG_DSP_SafeloadWithExt] = AP_MsgSafeloadWithExtDsp;

	inst->msg[MSG_DSP_SCENE_Change] = AP_MsgSceneChangeDsp;

	//场景
	inst->scene = Scene_Open();

	return inst;
}
