FangnanWei/ActiveAmplifier/(commit log)

2019-12-21 添加文档
2019-12-21 老项目代码
2019-12-22 模拟i2c
2019-12-23 添加代码
2019-12-25 i2c-eeprom ok
2019-12-25 Create MO-2300D OLED 界面设计-V1.00.rar
2019-12-29 驱动基本完整
2019-12-29 Windows重装系统
2020-01-08 调整代码结构
    [串口协议.xls]
2020-01-12 采用UTF8编码
2020-01-14 V1.0.1-2020年1月14日
